BlueBlue-wk/Balance-Car/软件工程/Matlab仿真/test3.txt

88 AF 1C 02 3F 3B 66 3F 3F 3F 3F 3F 3F 3F 3F 3F 03 6A 98 88 3F 1C 02 3F 44 3B 3F 3F 3F 3F 3F 3F 3F 3F 3F 3F 03 6A F3 88 3F 1C 02 3F 32 3B 3F 3F 3F 3F 3F 3F 3F 3F 3F 3F 03 6A 46 88 AF 1C 02 72 0A 3B 66 3F 3F 3F 3F 3F 3F 3F 3F 3F 03 6A 7D 88 AF 1C 02 3F 26 3B 78 3F 3F 3F 3F 3F 3F 3F 3F 3F 03 6A F1 88 3F 1C 02 3F 32 3B 3F 3F 3F 3F 3F 3F 3F 3F 3F 3F 03 6A 7A 88 AF 1C 02 3F 3F 3F 3B 3F 3F 3F 3F 3F 3F 3F 3F 3F 3F 03 69 07 88 AF 1C 02 3F 36 3B 3F 3F 3F 3F 3F 3F 3F 3F 3F 3F 03 69 FA 88 3F 1C 02 5C 3F 3F 3B 3F 3F 3F 3F 3F 3F 3F 3F 3F 3F 03 6A 22 88 AF 1C 02 3F 3F 3F 3B 78 3F 3F 3F 3F 3F 3F 3F 3F 3F 03 6A 97 88 3F 1C 02 3F 02 3B 3F 3F 3F 3F 3F 3F 3F 3F 3F 3F 03 6A E1 88 3F 1C 02 54 06 3B 66 3F 3F 3F 3F 3F 3F 3F 3F 3F 03 6B 48 88 AF 1C 02 3F 14 3B 7A 3F 3F 3F 3F 3F 3F 3F 3F 3F 03 6B A1 88 3F 1C 02 72 0E 3B 76 3F 3F 3F 3F 3F 3F 3F 3F 3F 03 6B 7F 88 AF 1C 02 76 5C 3B 3F 3F 3F 3F 3F 3F 3F 3F 3F 3F 03 6B FB 88 3F 1C 02 3F 4C 3B 3F 3F 3F 3F 3F 3F 3F 3F 3F 3F 03 6A AA 88 3F 1C 02 3F 3F 3F 3C 04 3F 3F 3F 3F 03 3F 3F 3F 03 6A 43 88 AF 1C 02 64 3F 3F 3B 3F 3F 3F 3F 3F 3F 3F 3F 3F 3F 03 6B 6B 88 AF 1C 02 60 3F 3F 3B 66 3F 3F 3F 3F 3F 3F 3F 3F 3F 03 6B 07 88 AF 1C 02 3F 3F 3F 3B 7C 3F 3F 3F 3F 3F 3F 3F 3F 3F 03 6B 2C 88 AF 1C 02 5A 3F 3F 3B 3F 3F 3F 3F 3F 3F 3F 3F 3F 3F 03 6B 77 88 AF 1C 02 3F 3B 3F 3F 3F 3F 3F 3F 3F 3F 3F 3F 03 6B 56 88 AF 1C 02 32 3F 3B 50 3F 3F 3F 3F 32 3F 3F 3F 03 6C A7 88 3F 1C 02 3F 3F 7E 3C 24 3F 3F 3F 3F 3F 3F 3F 3F 3F 03 6B 12 88 AF 1C 03 3F 56 3C 1A 3F 3F 3F 3F 3F 3F 3F 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
