BlueBlue-wk/Balance-Car/(notices)

Notices in the files:
软件工程/自平衡小车/BLE/ble_uart.c:
Copyright(C) ¹ãÖÝÊÐÐÇÒíµç×Ó¿Æ¼¼ÓÐÏÞ¹«Ë¾ 2020-2030
All rights reserved
软件工程/自平衡小车/HARDWARE/USART3/usart3.h:
Copyright(C) ¹ãÖÝÊÐÐÇÒíµç×Ó¿Æ¼¼ÓÐÏÞ¹«Ë¾ 2009-2019
软件工程/自平衡小车/HARDWARE/OLED/oled.h:
Copyright(C) ÖÐ¾°Ô°µç×Ó2014/3/16
软件工程/自平衡小车/HARDWARE/IIC/myiic.h:
Copyright(C) ÕýµãÔ­×Ó 2009-2019
软件工程/自平衡小车/MPU6050/mpu6050.c:
Copyright(C) ¹ãÖÝÊÐÐÇÒíµç×Ó¿Æ¼¼ÓÐÏÞ¹«Ë¾ 2014-2024
